bjohan/yig_filter_bank_controller/pcb/yigController.pdf

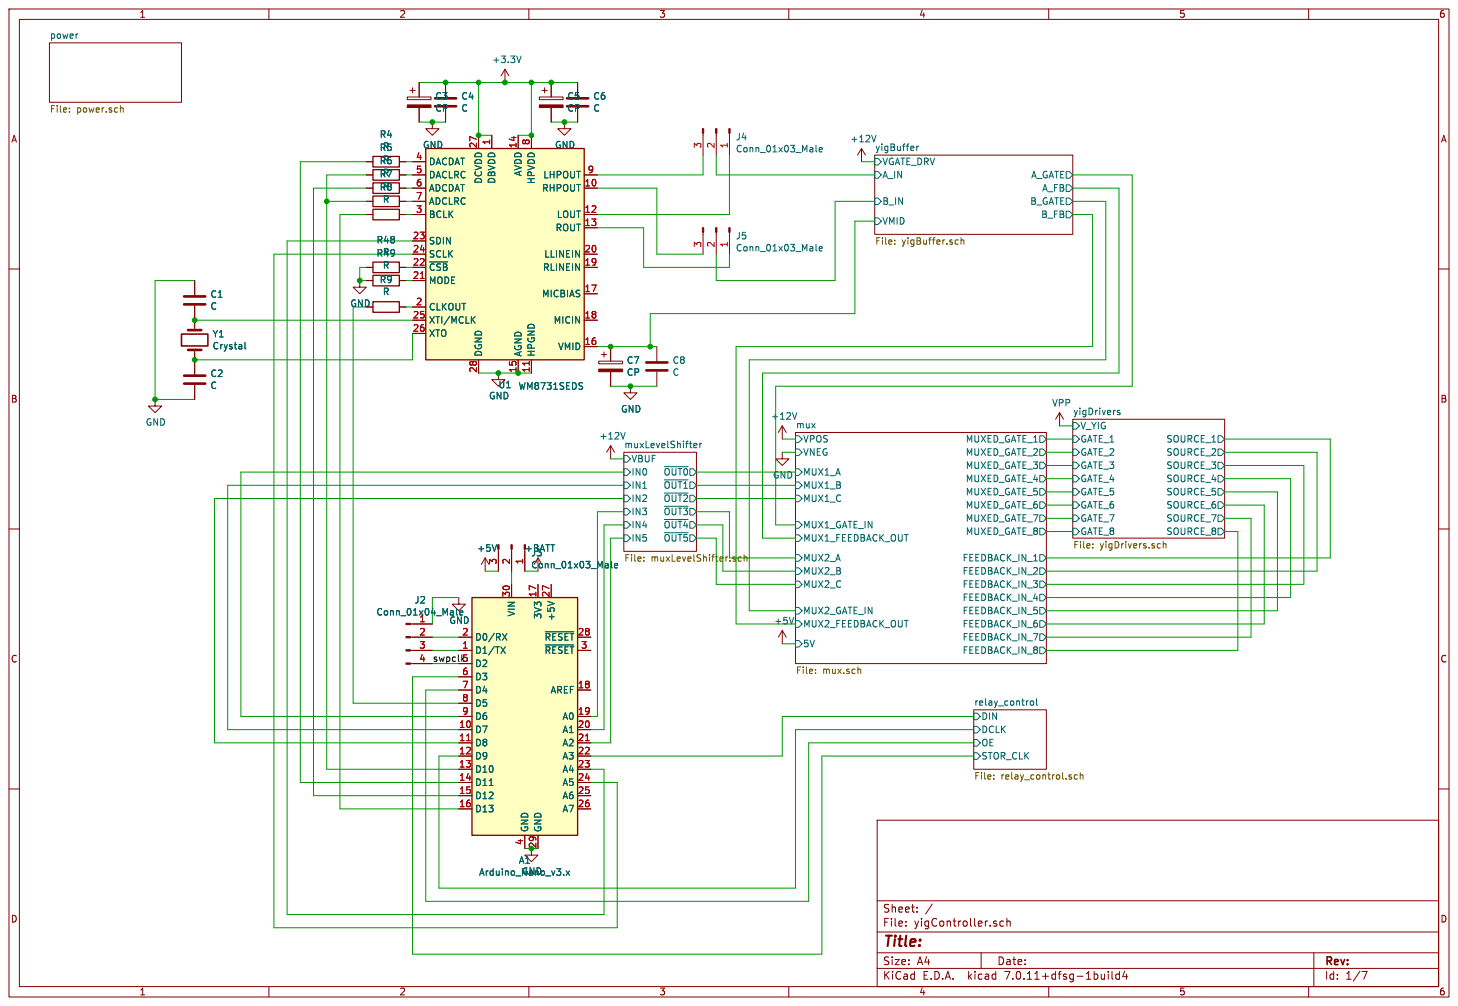
[picture p40: page 1]

power File: power.sch

yigDrivers File: yigDrivers.sch VPOS

Id: 1/7 Title: File: yigController.sch Sheet: /

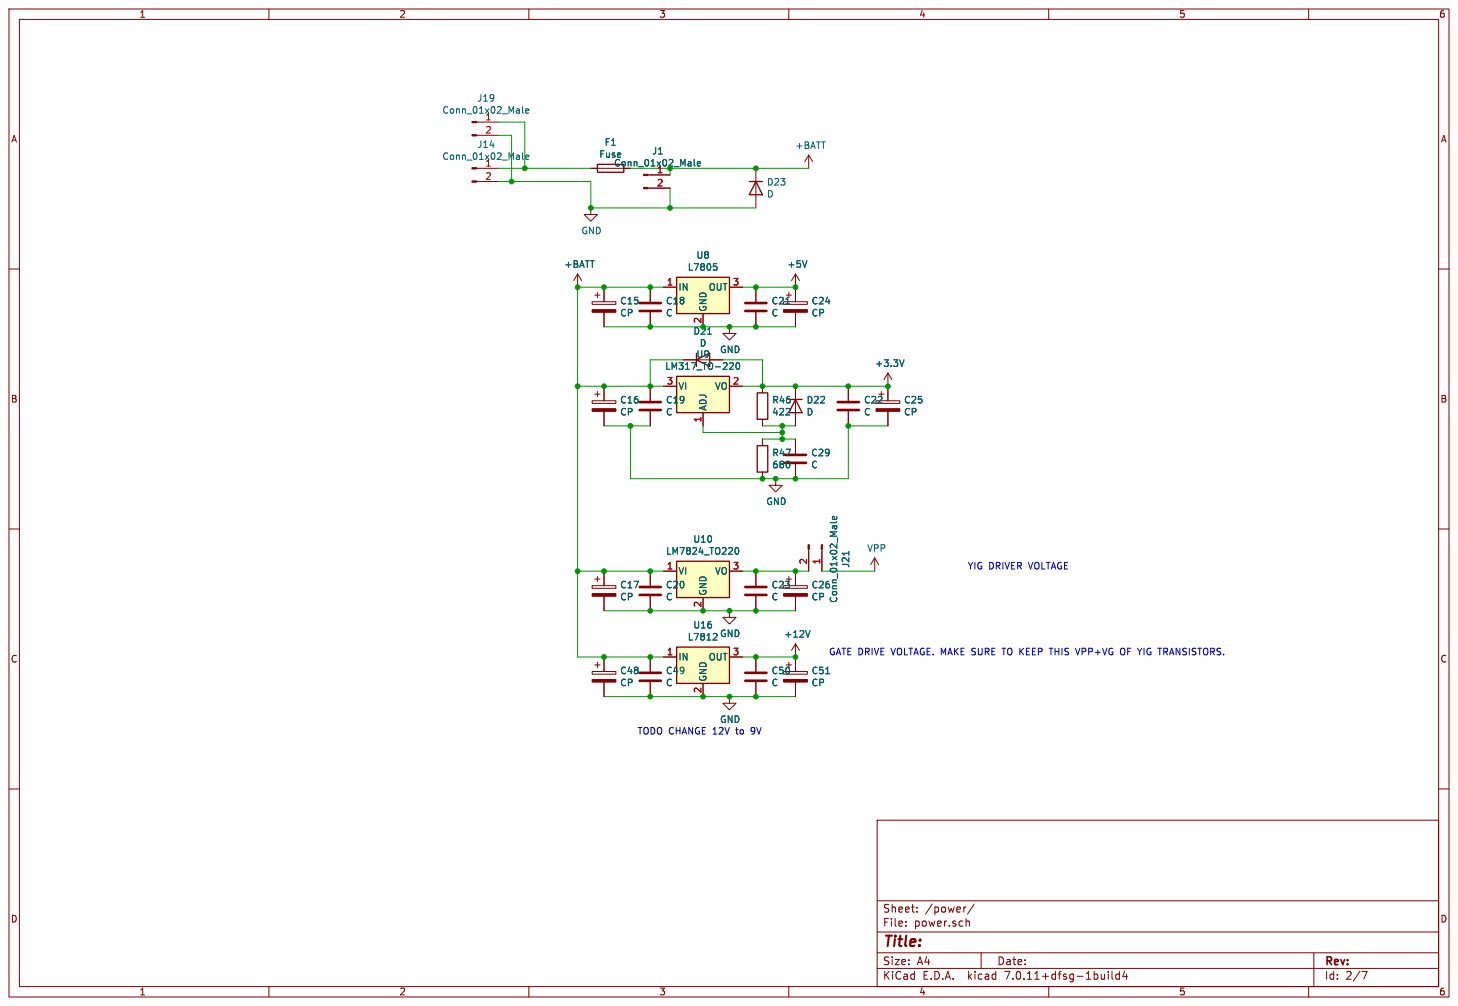
[picture p41: page 2]

Id: 2/7 Title: File: power.sch Sheet: /power/

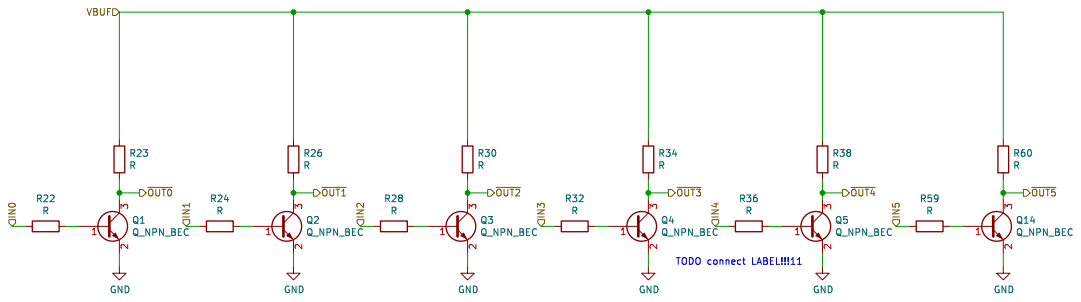
[picture p42: page 3]

Id: 3/7 Title: File: muxLevelShifter.sch Sheet: /muxLevelShifter/ GND

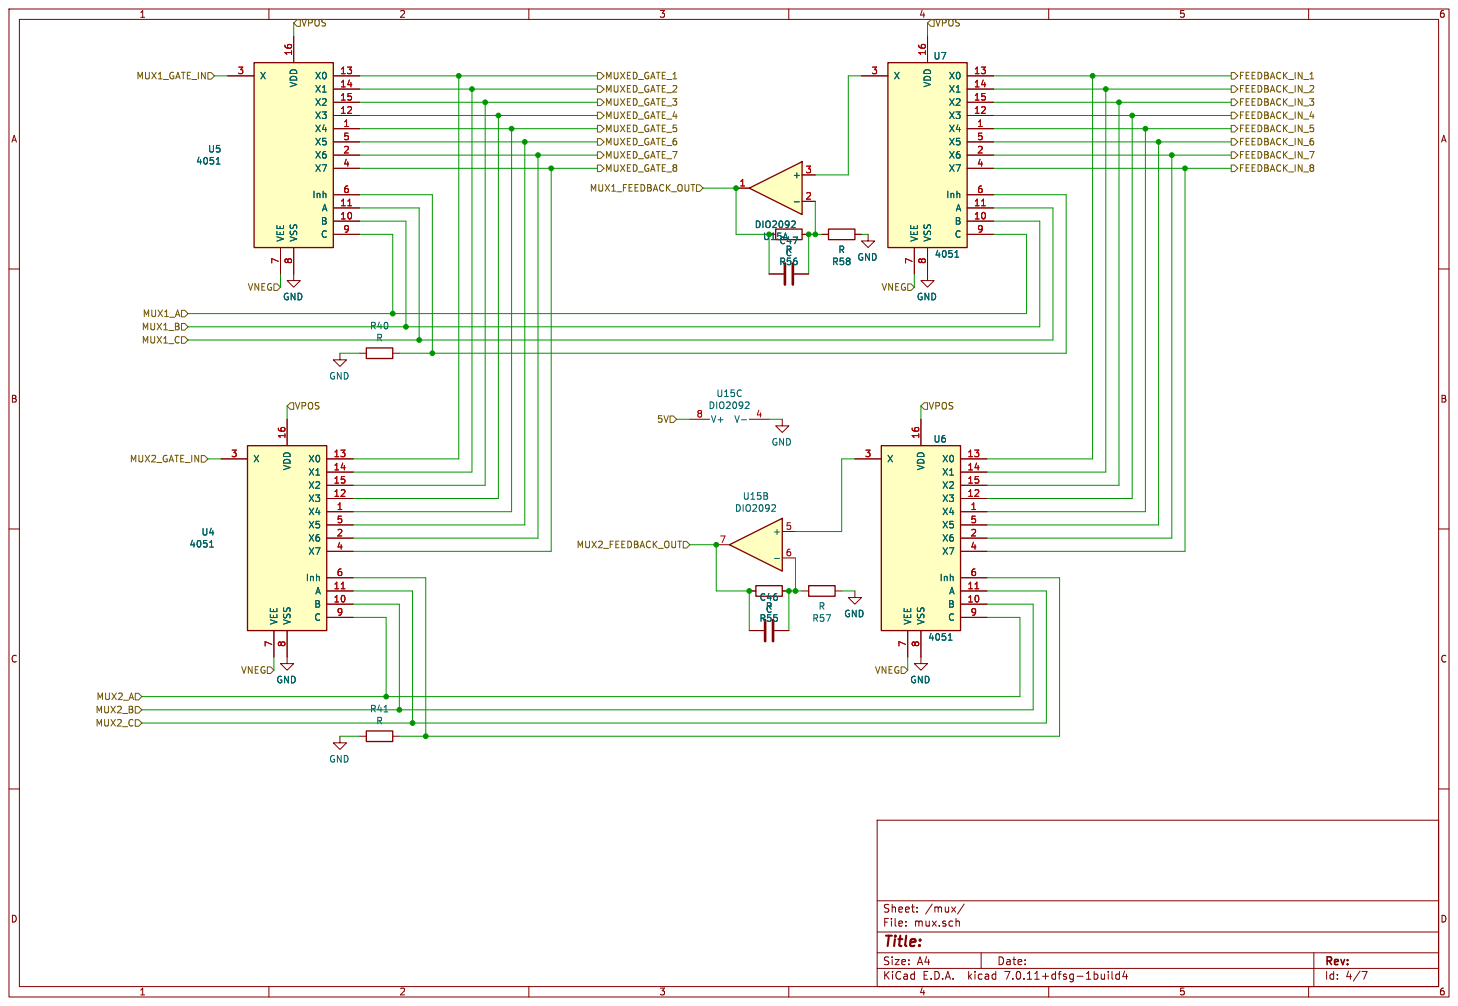
[picture p43: page 4]

Id: 4/7 Title: File: mux.sch Sheet: /mux/ GND GND

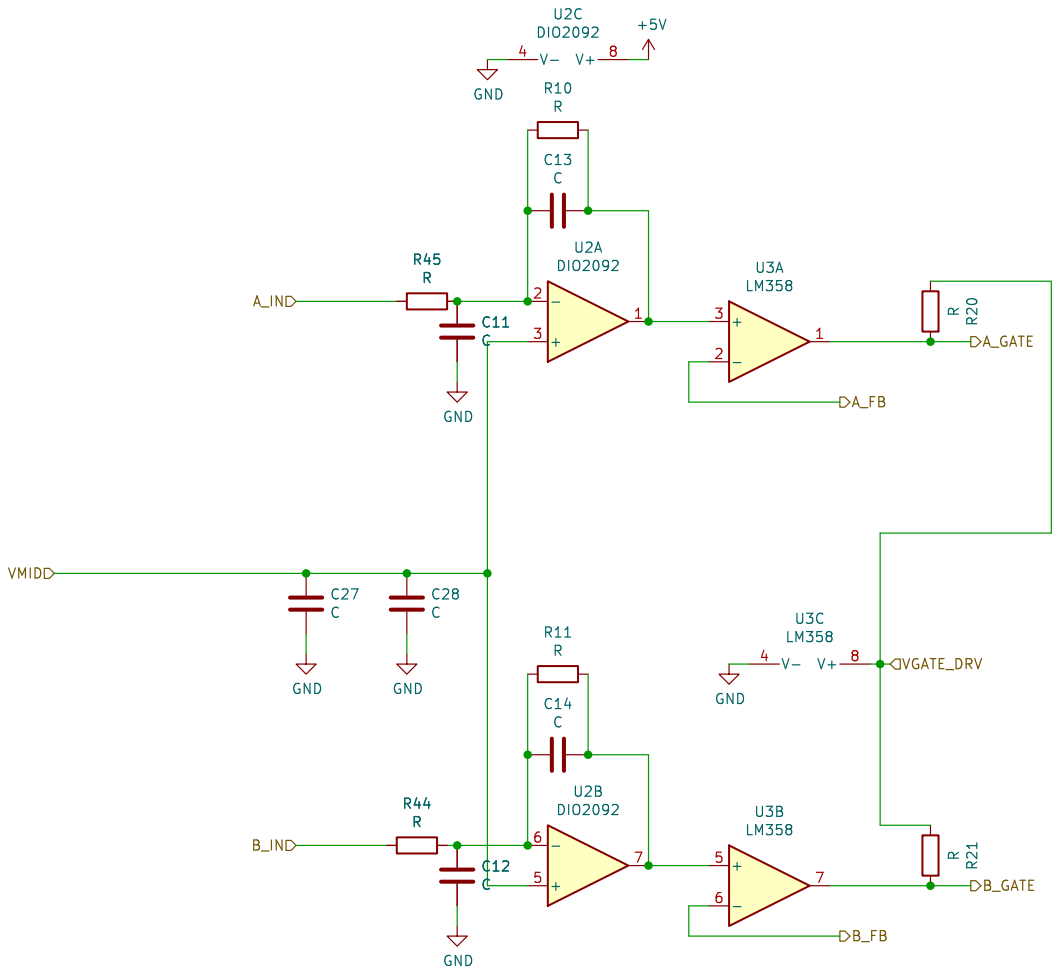
[picture p44: page 5]

Id: 5/7 Title: File: yigBuffer.sch Sheet: /yigBuffer/

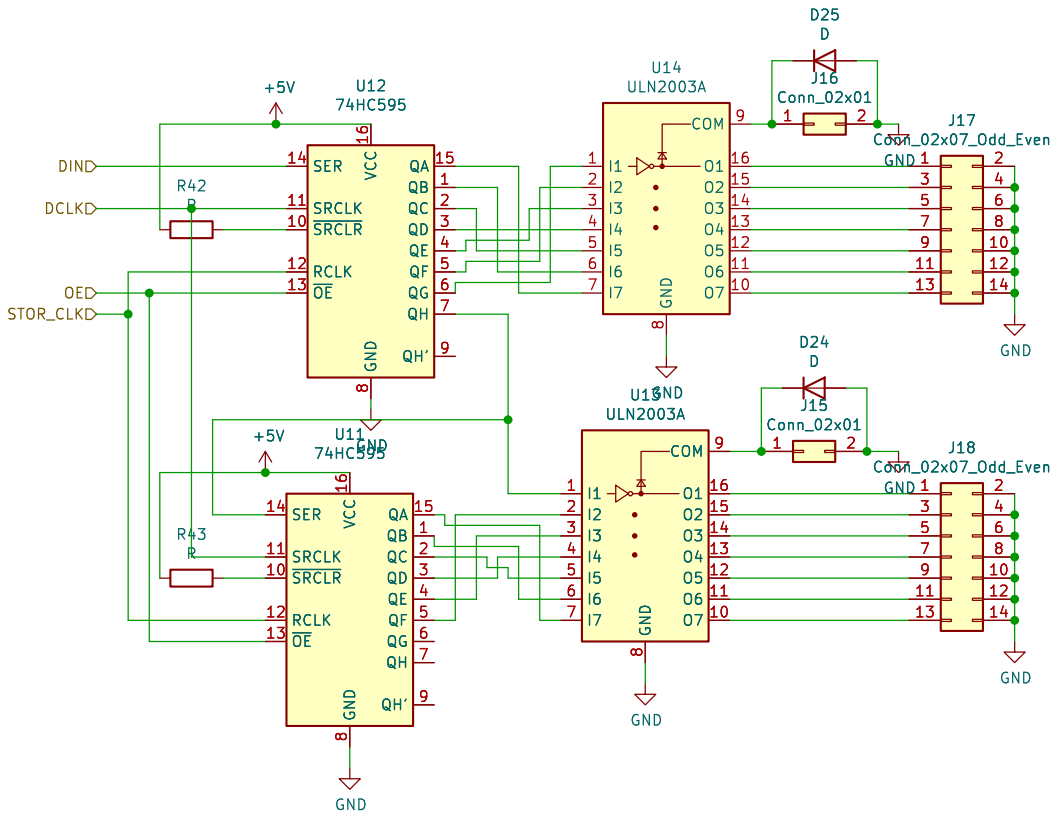
[picture p45: page 6]

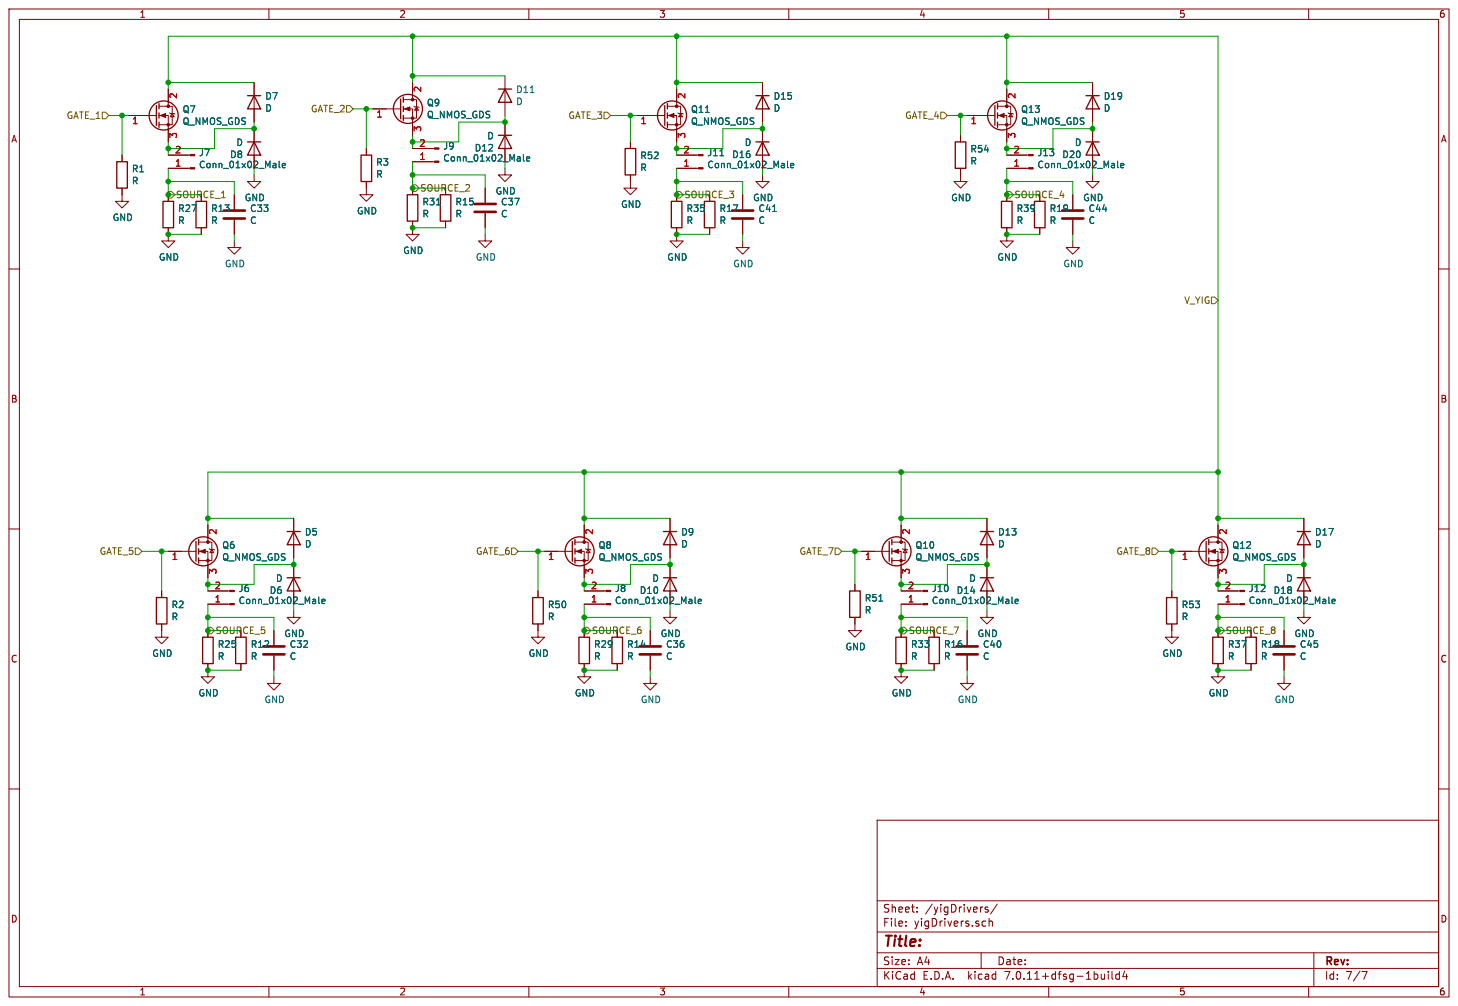
[picture p46: page 7]

Id: 7/7 Title: File: yigDrivers.sch Sheet: /yigDrivers/
