bjohan/yig_filter_bank_controller/pcb/yigController.kicad_pcb

## KiCad design pcb/yigController.kicad_pcb (2024-11-19)

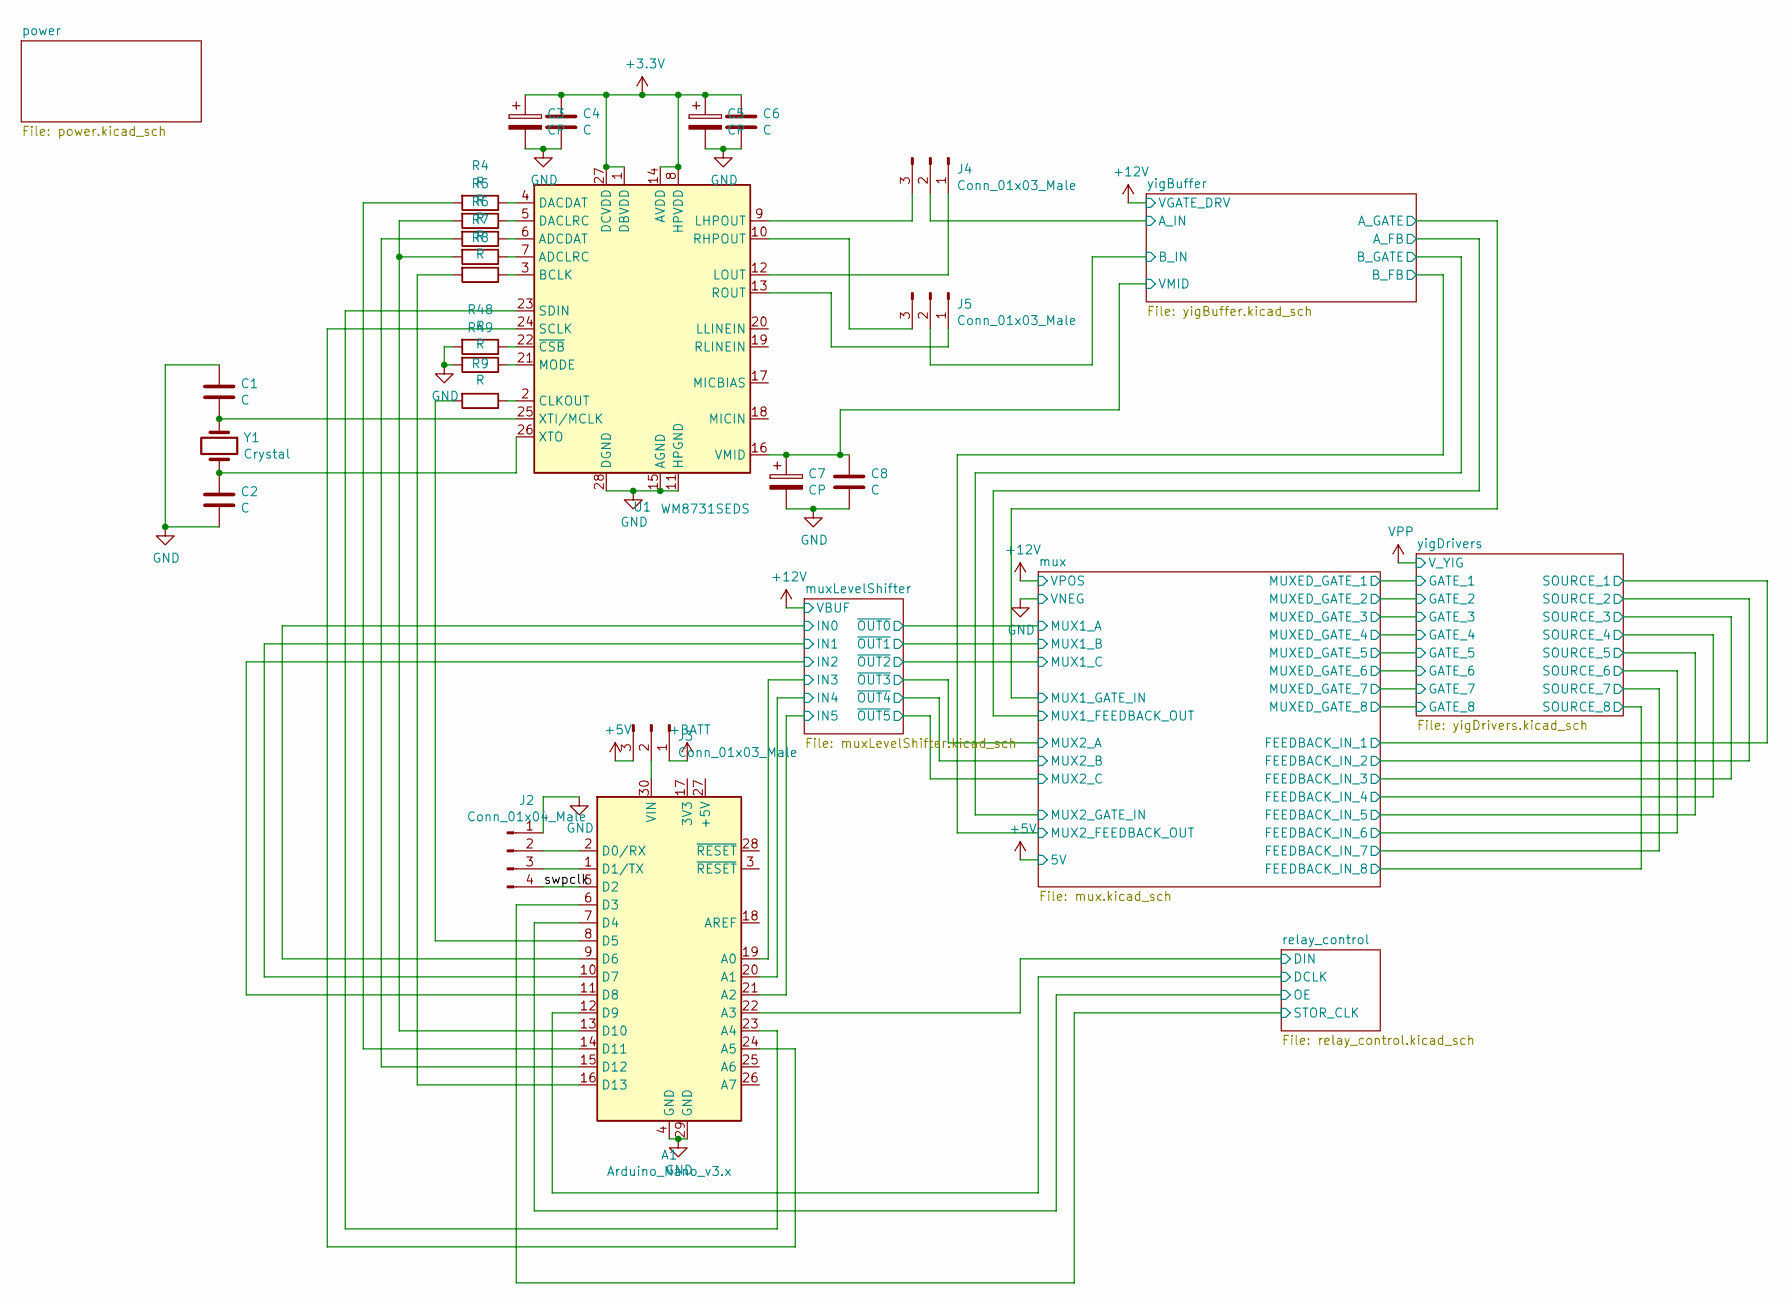
[picture p47: schematic yigController.kicad_sch]

Parts:
A1: Arduino_Nano_v3.x; Arduino_Nano
C1, C2, C4, C6, C8: C; C_1206_3216Metric
C3, C5, C7: CP; C_1206_3216Metric
J2: Conn_01x04_Male; PinHeader_1x04_P2.54mm_Vertical
J3, J4, J5: Conn_01x03_Male; PinHeader_1x03_P2.54mm_Vertical
R4, R5, R6, R7, R8, R9, R48, R49: R; R_1206_3216Metric
U1: WM8731SEDS; SSOP-28_5.3x10.2mm_P0.65mm
Y1: Crystal; Crystal_HC49-4H_Vertical

Connections:
+3V3: C3.1, C4.1, C5.1, C6.1, U1.1 (DBVDD), U1.8 (HPVDD), U1.14 (AVDD), U1.27 (DCVDD); also elsewhere on the board
+5V: J3.3; also elsewhere on the board
+BATT: J3.1; also elsewhere on the board
/muxLevelShifter/IN0: A1.9 (D6); also elsewhere on the board
/muxLevelShifter/IN1: A1.10 (D7); also elsewhere on the board
/muxLevelShifter/IN2: A1.11 (D8); also elsewhere on the board
/muxLevelShifter/IN3: A1.19 (A0); also elsewhere on the board
/muxLevelShifter/IN4: A1.20 (A1); also elsewhere on the board
/muxLevelShifter/IN5: A1.21 (A2); also elsewhere on the board
/relay_control/DCLK: A1.12 (D9); also elsewhere on the board
/relay_control/DIN: A1.22 (A3); also elsewhere on the board
/relay_control/OE: A1.7 (D4); also elsewhere on the board
/relay_control/STOR_CLK: A1.6 (D3); also elsewhere on the board
/swpclk: A1.5 (D2), J2.4
/yigBuffer/A_IN: J4.2; also elsewhere on the board
/yigBuffer/B_IN: J5.2; also elsewhere on the board
/yigBuffer/VMID: C7.1, C8.1, U1.16 (VMID); also elsewhere on the board
GND: A1.4 (GND), A1.29 (GND), C1.1, C2.2, C3.2, C4.2, C5.2, C6.2, C7.2, C8.2, J2.1, R48.2, R49.2, U1.11 (HPGND), U1.15 (AGND), U1.28 (DGND); also elsewhere on the board
unnamed: A1.1 (D1/TX), J2.3
unnamed: A1.2 (D0/RX), J2.2
unnamed: A1.8 (D5), R9.2
unnamed: A1.13 (D10), R5.2, R7.2
unnamed: A1.14 (D11), R4.2
unnamed: A1.15 (D12), R6.2
unnamed: A1.16 (D13), R8.2
unnamed: A1.23 (A4), U1.23 (SDIN)
unnamed: A1.24 (A5), U1.24 (SCLK)
unnamed: A1.30 (VIN), J3.2
unnamed: C1.2, U1.25 (XTI/MCLK), Y1.1
unnamed: C2.1, U1.26 (XTO), Y1.2
unnamed: J4.1, U1.12 (LOUT)
unnamed: J4.3, U1.9 (LHPOUT)
unnamed: J5.1, U1.13 (ROUT)
unnamed: J5.3, U1.10 (RHPOUT)
unnamed: R4.1, U1.4 (DACDAT)
unnamed: R5.1, U1.5 (DACLRC)
unnamed: R6.1, U1.6 (ADCDAT)
unnamed: R7.1, U1.7 (ADCLRC)
unnamed: R8.1, U1.3 (BCLK)
unnamed: R9.1, U1.2 (CLKOUT)
unnamed: R48.1, U1.22 (~CSB)
unnamed: R49.1, U1.21 (MODE)

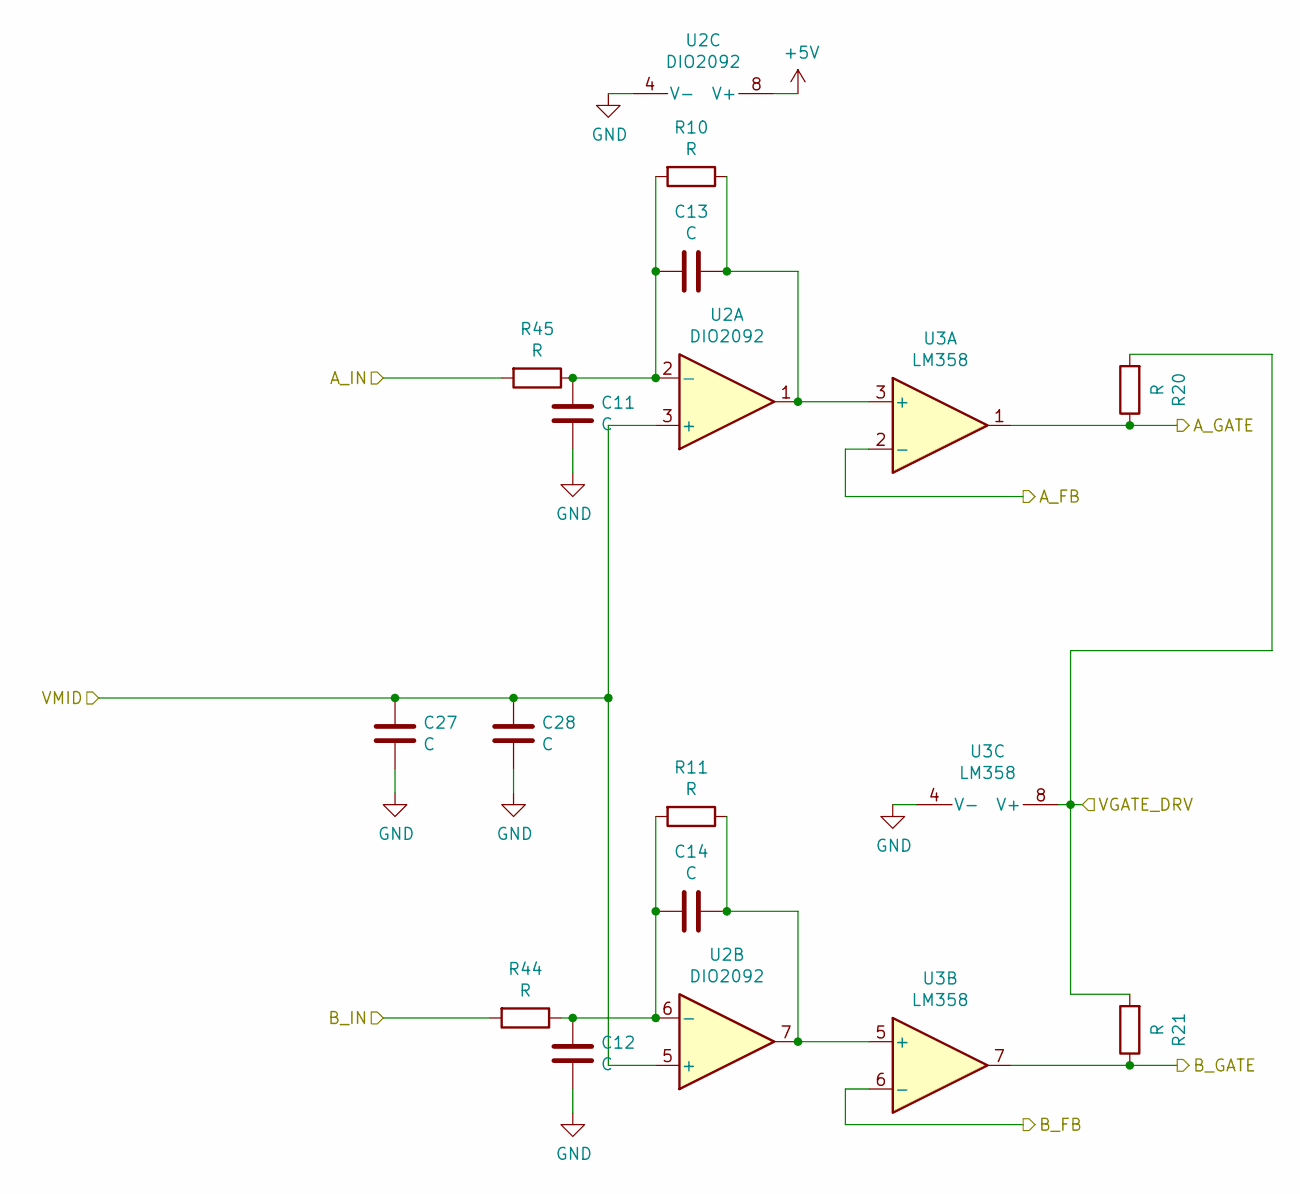
[picture p48: schematic yigBuffer.kicad_sch]

Parts:
C11, C12, C13, C14, C27, C28: C; C_1206_3216Metric
R10, R11, R20, R21, R44, R45: R; R_1206_3216Metric
U2: DIO2092; SOIC-8_3.9x4.9mm_P1.27mm
U3: LM358; SOIC-8_3.9x4.9mm_P1.27mm

Connections:
+5V: U2.8 (V+); also elsewhere on the board
+12V: R20.2, R21.2, U3.8 (V+); also elsewhere on the board
/yigBuffer/A_FB: U3.2 (-); also elsewhere on the board
/yigBuffer/A_GATE: R20.1, U3.1; also elsewhere on the board
/yigBuffer/A_IN: R45.2; also elsewhere on the board
/yigBuffer/B_FB: U3.6 (-); also elsewhere on the board
/yigBuffer/B_GATE: R21.1, U3.7; also elsewhere on the board
/yigBuffer/B_IN: R44.2; also elsewhere on the board
/yigBuffer/VMID: C27.1, C28.1, U2.3 (+), U2.5 (+); also elsewhere on the board
GND: C11.2, C12.2, C27.2, C28.2, U2.4 (V-), U3.4 (V-); also elsewhere on the board
unnamed: C11.1, C13.2, R10.2, R45.1, U2.2 (-)
unnamed: C12.1, C14.2, R11.2, R44.1, U2.6 (-)
unnamed: C13.1, R10.1, U2.1, U3.3 (+)
unnamed: C14.1, R11.1, U2.7, U3.5 (+)

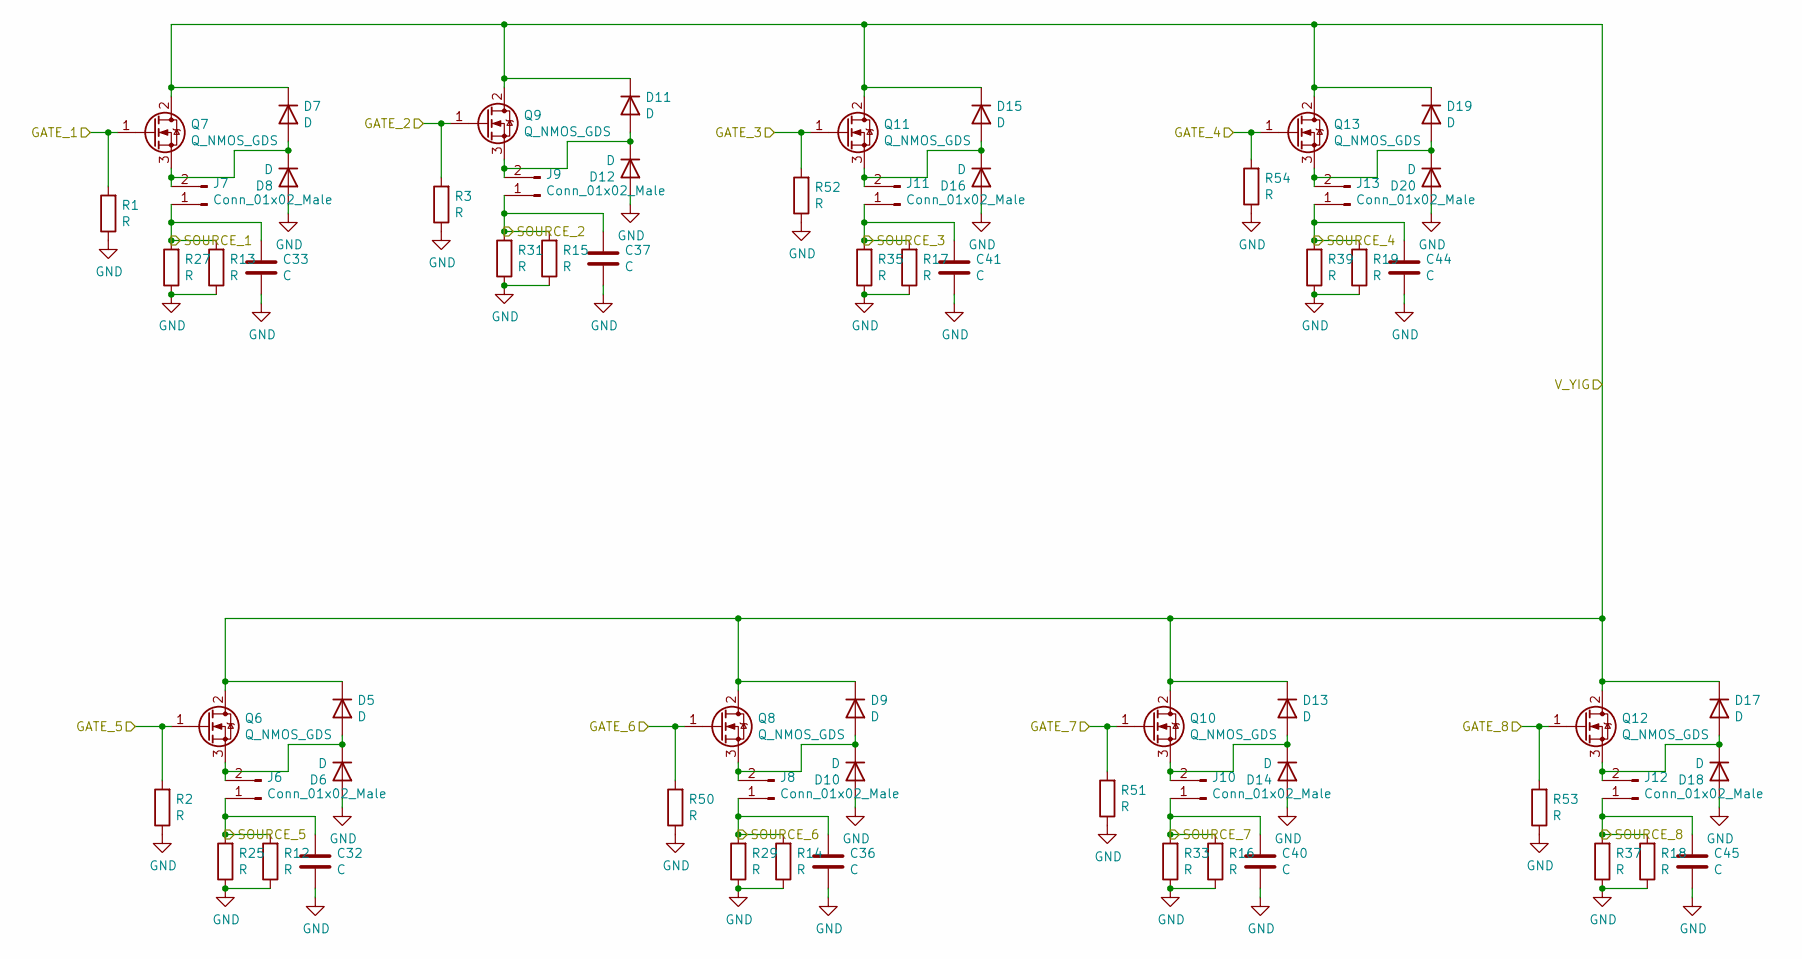
[picture p49: schematic yigDrivers.kicad_sch]

Parts:
C32, C33, C36, C37, C40, C41, C44, C45: C; C_1206_3216Metric
D5, D6, D7, D8, D9, D10, D11, D12, D13, D14, D15, D16, D17, D18, D19, D20: D; D_2010_5025Metric
J6, J7, J8, J9, J10, J11, J12, J13: Conn_01x02_Male; PinHeader_1x02_P2.54mm_Vertical
Q6, Q7, Q8, Q9, Q10, Q11, Q12, Q13: Q_NMOS_GDS; TO-220-3_Vertical
R1, R2, R3, R50, R51, R52, R53, R54: R; R_1206_3216Metric
R12, R13, R14, R15, R16, R17, R18, R19: R; R_2512_6332Metric
R25, R27, R29, R31, R33, R35, R37, R39: R; R_4020_10251Metric

Connections:
/mux/FEEDBACK_IN_1: C33.1, J7.1, R13.2, R27.2; also elsewhere on the board
/mux/FEEDBACK_IN_2: C37.1, J9.1, R15.2, R31.2; also elsewhere on the board
/mux/FEEDBACK_IN_3: C41.1, J11.1, R17.2, R35.2; also elsewhere on the board
/mux/FEEDBACK_IN_4: C44.1, J13.1, R19.2, R39.2; also elsewhere on the board
/mux/FEEDBACK_IN_5: C32.1, J6.1, R12.2, R25.2; also elsewhere on the board
/mux/FEEDBACK_IN_6: C36.1, J8.1, R14.2, R29.2; also elsewhere on the board
/mux/FEEDBACK_IN_7: C40.1, J10.1, R16.2, R33.2; also elsewhere on the board
/mux/FEEDBACK_IN_8: C45.1, J12.1, R18.2, R37.2; also elsewhere on the board
/yigDrivers/GATE_1: Q7.1 (G), R1.2; also elsewhere on the board
/yigDrivers/GATE_2: Q9.1 (G), R3.2; also elsewhere on the board
/yigDrivers/GATE_3: Q11.1 (G), R52.2; also elsewhere on the board
/yigDrivers/GATE_4: Q13.1 (G), R54.2; also elsewhere on the board
/yigDrivers/GATE_5: Q6.1 (G), R2.2; also elsewhere on the board
/yigDrivers/GATE_6: Q8.1 (G), R50.2; also elsewhere on the board
/yigDrivers/GATE_7: Q10.1 (G), R51.2; also elsewhere on the board
/yigDrivers/GATE_8: Q12.1 (G), R53.2; also elsewhere on the board
GND: C32.2, C33.2, C36.2, C37.2, C40.2, C41.2, C44.2, C45.2, D6.2 (A), D8.2 (A), D10.2 (A), D12.2 (A), D14.2 (A), D16.2 (A), D18.2 (A), D20.2 (A), R1.1, R2.1, R3.1, R12.1, R13.1, R14.1, R15.1, R16.1, R17.1, R18.1, R19.1, R25.1, R27.1, R29.1, R31.1, R33.1, R35.1, R37.1, R39.1, R50.1, R51.1, R52.1, R53.1, R54.1; also elsewhere on the board
unnamed: D5.2 (A), D6.1 (K), J6.2, Q6.3 (S)
unnamed: D7.2 (A), D8.1 (K), J7.2, Q7.3 (S)
unnamed: D9.2 (A), D10.1 (K), J8.2, Q8.3 (S)
unnamed: D11.2 (A), D12.1 (K), J9.2, Q9.3 (S)
unnamed: D13.2 (A), D14.1 (K), J10.2, Q10.3 (S)
unnamed: D15.2 (A), D16.1 (K), J11.2, Q11.3 (S)
unnamed: D17.2 (A), D18.1 (K), J12.2, Q12.3 (S)
unnamed: D19.2 (A), D20.1 (K), J13.2, Q13.3 (S)
VPP: D5.1 (K), D7.1 (K), D9.1 (K), D11.1 (K), D13.1 (K), D15.1 (K), D17.1 (K), D19.1 (K), Q6.2 (D), Q7.2 (D), Q8.2 (D), Q9.2 (D), Q10.2 (D), Q11.2 (D), Q12.2 (D), Q13.2 (D); also elsewhere on the board

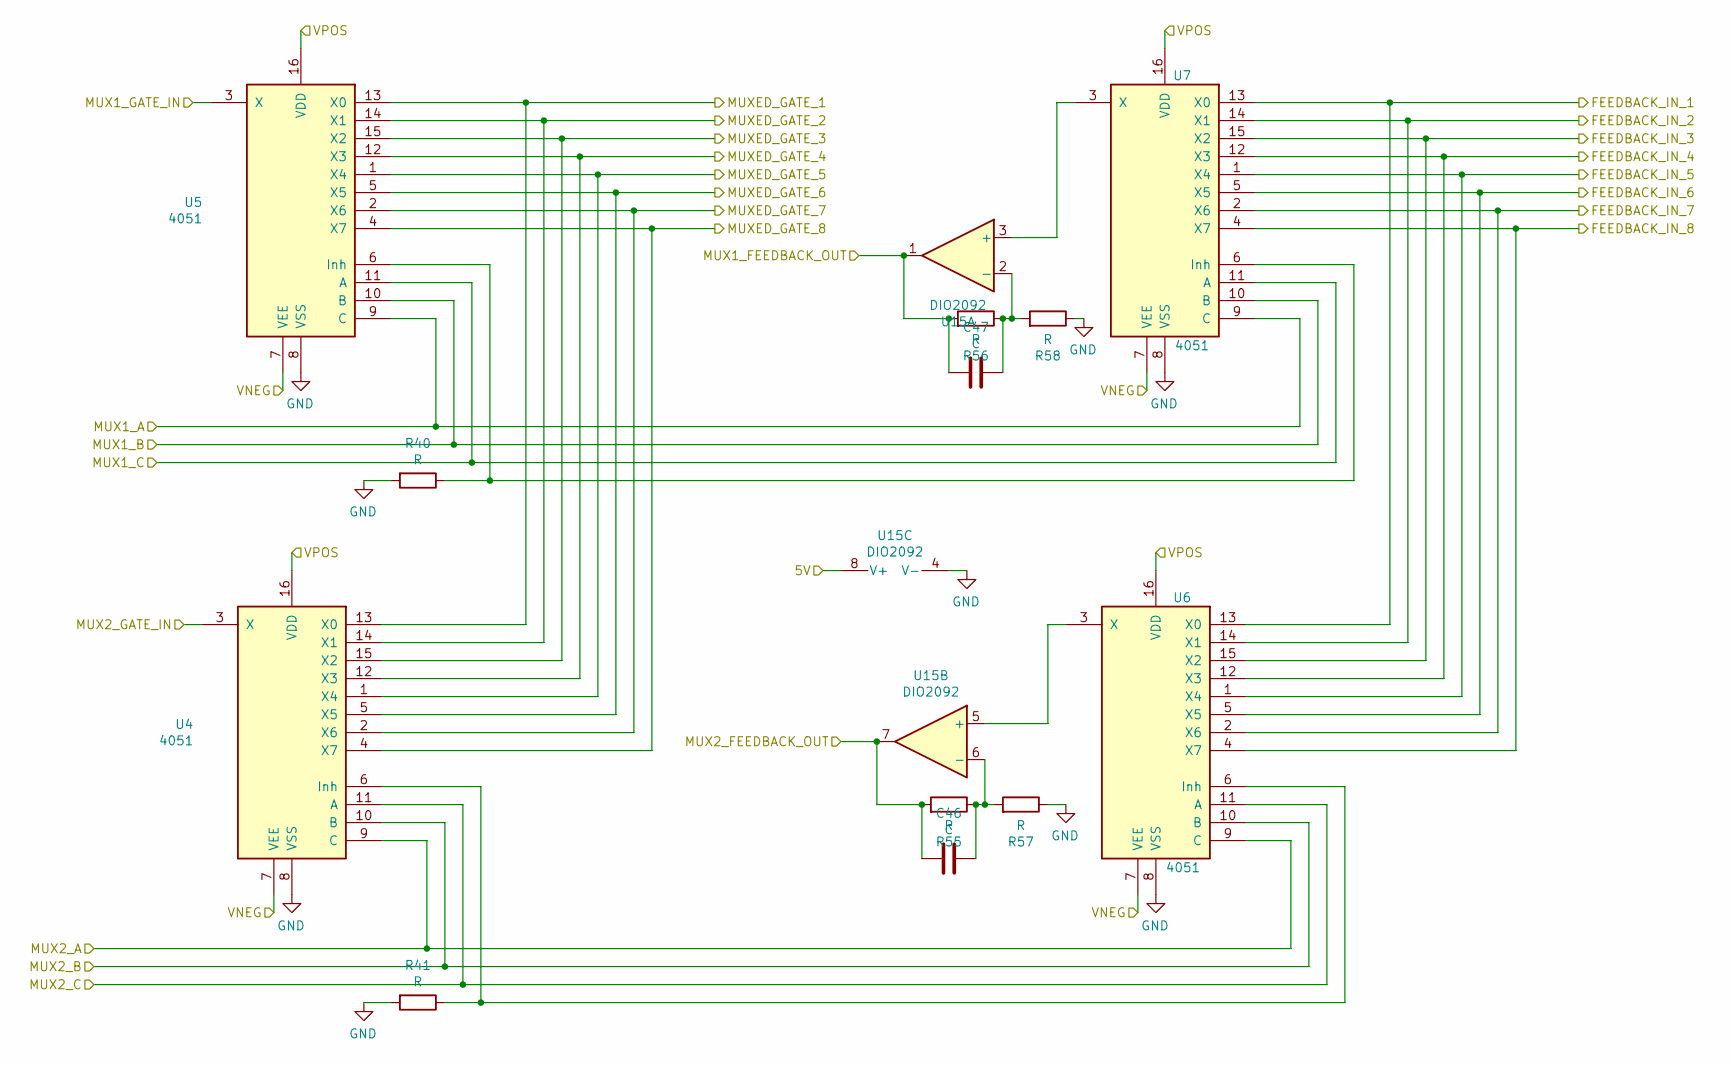
[picture p50: schematic mux.kicad_sch]

Parts:
C46, C47: C; C_1206_3216Metric
R40, R41, R55, R56, R57, R58: R; R_1206_3216Metric
U4, U5, U6, U7: 4051; SOIC-16_3.9x9.9mm_P1.27mm
U15: DIO2092; SOIC-8_3.9x4.9mm_P1.27mm

Connections:
+5V: U15.8 (V+); also elsewhere on the board
+12V: U4.16 (VDD), U5.16 (VDD), U6.16 (VDD), U7.16 (VDD); also elsewhere on the board
/mux/FEEDBACK_IN_1: U6.13 (X0), U7.13 (X0); also elsewhere on the board
/mux/FEEDBACK_IN_2: U6.14 (X1), U7.14 (X1); also elsewhere on the board
/mux/FEEDBACK_IN_3: U6.15 (X2), U7.15 (X2); also elsewhere on the board
/mux/FEEDBACK_IN_4: U6.12 (X3), U7.12 (X3); also elsewhere on the board
/mux/FEEDBACK_IN_5: U6.1 (X4), U7.1 (X4); also elsewhere on the board
/mux/FEEDBACK_IN_6: U6.5 (X5), U7.5 (X5); also elsewhere on the board
/mux/FEEDBACK_IN_7: U6.2 (X6), U7.2 (X6); also elsewhere on the board
/mux/FEEDBACK_IN_8: U6.4 (X7), U7.4 (X7); also elsewhere on the board
/mux/MUX1_A: U5.9 (C), U7.9 (C); also elsewhere on the board
/mux/MUX1_B: U5.10 (B), U7.10 (B); also elsewhere on the board
/mux/MUX1_C: U5.11 (A), U7.11 (A); also elsewhere on the board
/mux/MUX2_A: U4.9 (C), U6.9 (C); also elsewhere on the board
/mux/MUX2_B: U4.10 (B), U6.10 (B); also elsewhere on the board
/mux/MUX2_C: U4.11 (A), U6.11 (A); also elsewhere on the board
/yigBuffer/A_FB: C47.2, R56.2, U15.1; also elsewhere on the board
/yigBuffer/A_GATE: U5.3 (X); also elsewhere on the board
/yigBuffer/B_FB: C46.2, R55.2, U15.7; also elsewhere on the board
/yigBuffer/B_GATE: U4.3 (X); also elsewhere on the board
/yigDrivers/GATE_1: U4.13 (X0), U5.13 (X0); also elsewhere on the board
/yigDrivers/GATE_2: U4.14 (X1), U5.14 (X1); also elsewhere on the board
/yigDrivers/GATE_3: U4.15 (X2), U5.15 (X2); also elsewhere on the board
/yigDrivers/GATE_4: U4.12 (X3), U5.12 (X3); also elsewhere on the board
/yigDrivers/GATE_5: U4.1 (X4), U5.1 (X4); also elsewhere on the board
/yigDrivers/GATE_6: U4.5 (X5), U5.5 (X5); also elsewhere on the board
/yigDrivers/GATE_7: U4.2 (X6), U5.2 (X6); also elsewhere on the board
/yigDrivers/GATE_8: U4.4 (X7), U5.4 (X7); also elsewhere on the board
GND: R40.2, R41.2, R57.1, R58.1, U4.7 (VEE), U4.8 (VSS), U5.7 (VEE), U5.8 (VSS), U6.7 (VEE), U6.8 (VSS), U7.7 (VEE), U7.8 (VSS), U15.4 (V-); also elsewhere on the board
unnamed: C46.1, R55.1, R57.2, U15.6 (-)
unnamed: C47.1, R56.1, R58.2, U15.2 (-)
unnamed: R40.1, U5.6 (Inh), U7.6 (Inh)
unnamed: R41.1, U4.6 (Inh), U6.6 (Inh)
unnamed: U7.3 (X), U15.3 (+)
unnamed: U6.3 (X), U15.5 (+)

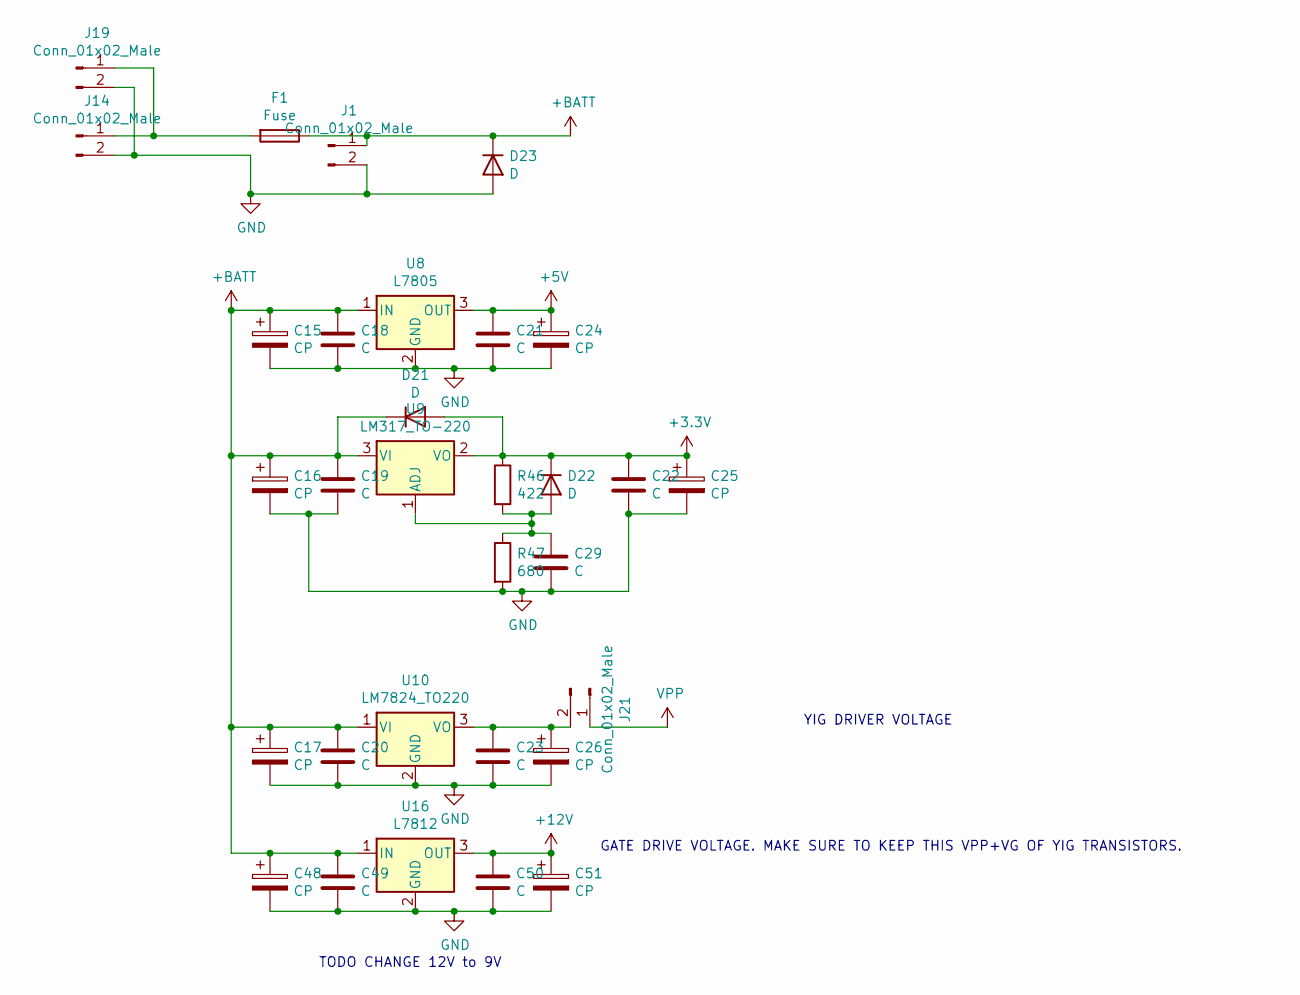
[picture p51: schematic power.kicad_sch]

Parts:
C15, C16, C17, C24, C25, C26, C48, C51: CP; CP_Elec_10x12.5
C18, C19, C20, C21, C22, C23, C29, C49, C50: C; C_1206_3216Metric
D21, D22, D23: D; D_2010_5025Metric
F1: Fuse; Fuse_1206_3216Metric
J1, J14, J19, J21: Conn_01x02_Male; PinHeader_1x02_P2.54mm_Vertical
R46: 422; R_1206_3216Metric
R47: 680; R_1206_3216Metric
U8: L7805; TO-220-3_Vertical
U9: LM317_TO-220; TO-220-3_Vertical
U10: LM7824_TO220; TO-220-3_Vertical
U16: L7812; TO-220-3_Vertical

Connections:
+3V3: C22.1, C25.1, D21.2 (A), D22.1 (K), R46.1, U9.2 (VO); also elsewhere on the board
+5V: C21.1, C24.1, U8.3 (OUT); also elsewhere on the board
+12V: C50.1, C51.1, U16.3 (OUT); also elsewhere on the board
+BATT: C15.1, C16.1, C17.1, C18.1, C19.1, C20.1, C48.1, C49.1, D21.1 (K), D23.1 (K), F1.1, J1.1, U8.1 (IN), U9.3 (VI), U10.1 (VI), U16.1 (IN); also elsewhere on the board
GND: C15.2, C16.2, C17.2, C18.2, C19.2, C20.2, C21.2, C22.2, C23.2, C24.2, C25.2, C26.2, C29.2, C48.2, C49.2, C50.2, C51.2, D23.2 (A), J1.2, J14.2, J19.2, R47.2, U8.2 (GND), U10.2 (GND), U16.2 (GND); also elsewhere on the board
unnamed: C23.1, C26.1, J21.2, U10.3 (VO)
unnamed: C29.1, D22.2 (A), R46.2, R47.1, U9.1 (ADJ)
unnamed: F1.2, J14.1, J19.1
VPP: J21.1; also elsewhere on the board

Notes on the sheet:
YIG DRIVER VOLTAGE
TODO CHANGE 12V to 9V
GATE DRIVE VOLTAGE. MAKE SURE TO KEEP THIS VPP+VG OF YIG TRANSISTORS.

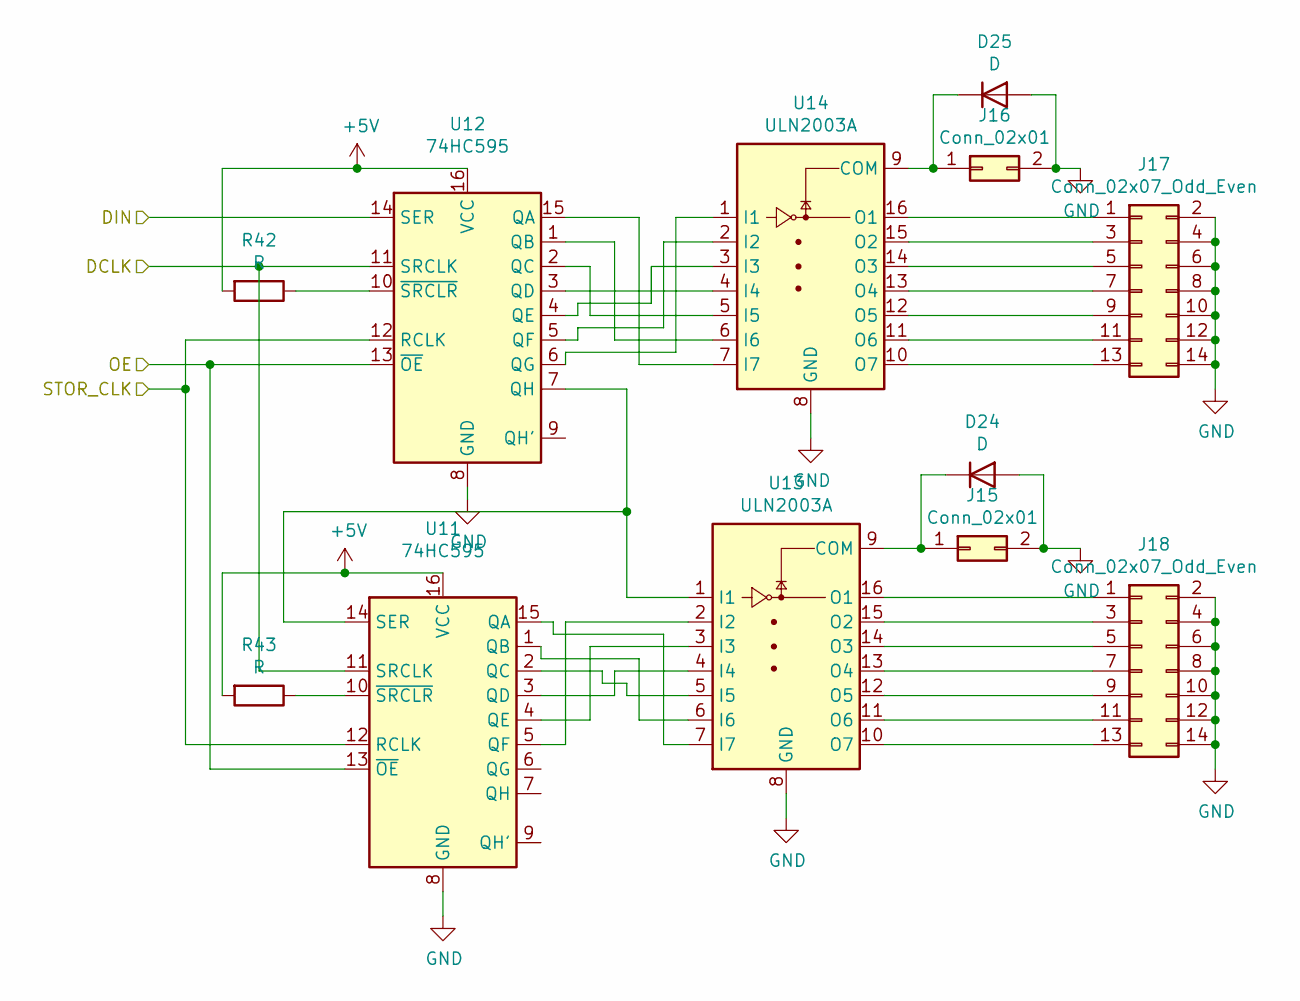
[picture p52: schematic relay_control.kicad_sch]

Parts:
D24, D25: D; D_2010_5025Metric
J15, J16: Conn_02x01; PinHeader_1x02_P2.54mm_Vertical
J17, J18: Conn_02x07_Odd_Even; PinHeader_2x07_P2.54mm_Vertical
R42, R43: R; R_1206_3216Metric
U11, U12: 74HC595; TSSOP-16_4.4x5mm_P0.65mm
U13, U14: ULN2003A; SOIC-16_3.9x9.9mm_P1.27mm

Connections:
+5V: R42.2, R43.2, U11.16 (VCC), U12.16 (VCC); also elsewhere on the board
/relay_control/DCLK: U11.11 (SRCLK), U12.11 (SRCLK); also elsewhere on the board
/relay_control/DIN: U12.14 (SER); also elsewhere on the board
/relay_control/OE: U11.13 (~OE), U12.13 (~OE); also elsewhere on the board
/relay_control/STOR_CLK: U11.12 (RCLK), U12.12 (RCLK); also elsewhere on the board
GND: D24.2 (A), D25.2 (A), J15.2, J16.2, J17.2, J17.4, J17.6, J17.8, J17.10, J17.12, J17.14, J18.2, J18.4, J18.6, J18.8, J18.10, J18.12, J18.14, U11.8 (GND), U12.8 (GND), U13.8 (GND), U14.8 (GND); also elsewhere on the board
unnamed: D24.1 (K), J15.1, U13.9 (COM)
unnamed: D25.1 (K), J16.1, U14.9 (COM)
unnamed: J17.1, U14.16 (O1)
unnamed: J17.3, U14.15 (O2)
unnamed: J17.5, U14.14 (O3)
unnamed: J17.7, U14.13 (O4)
unnamed: J17.9, U14.12 (O5)
unnamed: J17.11, U14.11 (O6)
unnamed: J17.13, U14.10 (O7)
unnamed: J18.1, U13.16 (O1)
unnamed: J18.3, U13.15 (O2)
unnamed: J18.5, U13.14 (O3)
unnamed: J18.7, U13.13 (O4)
unnamed: J18.9, U13.12 (O5)
unnamed: J18.11, U13.11 (O6)
unnamed: J18.13, U13.10 (O7)
unnamed: R42.1, U12.10 (~SRCLR)
unnamed: R43.1, U11.10 (~SRCLR)
unnamed: U11.1 (QB), U13.6 (I6)
unnamed: U11.2 (QC), U13.5 (I5)
unnamed: U11.3 (QD), U13.4 (I4)
unnamed: U11.4 (QE), U13.3 (I3)
unnamed: U11.5 (QF), U13.2 (I2)
unnamed: U11.14 (SER), U12.7 (QH), U13.1 (I1)
unnamed: U11.15 (QA), U13.7 (I7)
unnamed: U12.1 (QB), U14.6 (I6)
unnamed: U12.2 (QC), U14.5 (I5)
unnamed: U12.3 (QD), U14.4 (I4)
unnamed: U12.4 (QE), U14.3 (I3)
unnamed: U12.5 (QF), U14.2 (I2)
unnamed: U12.6 (QG), U14.1 (I1)
unnamed: U12.15 (QA), U14.7 (I7)

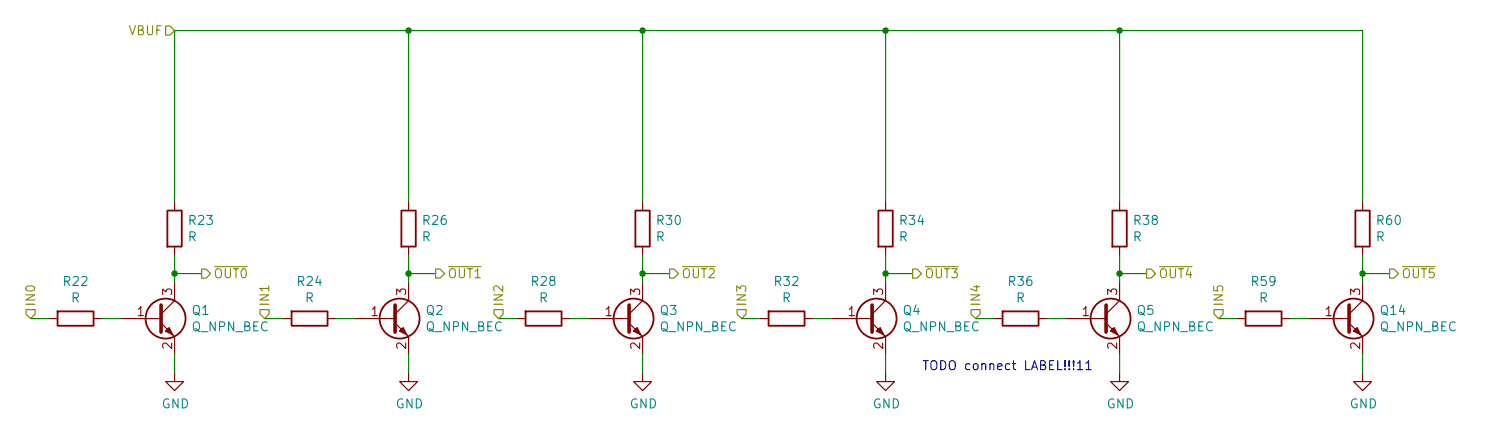
[picture p53: schematic muxLevelShifter.kicad_sch]

Parts:
Q1, Q2, Q3, Q4, Q5, Q14: Q_NPN_BEC; SOT-23
R22, R23, R24, R26, R28, R30, R32, R34, R36, R38, R59, R60: R; R_1206_3216Metric

Connections:
+12V: R23.1, R26.1, R30.1, R34.1, R38.1, R60.1; also elsewhere on the board
/mux/MUX1_A: Q1.3 (C), R23.2; also elsewhere on the board
/mux/MUX1_B: Q2.3 (C), R26.2; also elsewhere on the board
/mux/MUX1_C: Q3.3 (C), R30.2; also elsewhere on the board
/mux/MUX2_A: Q4.3 (C), R34.2; also elsewhere on the board
/mux/MUX2_B: Q5.3 (C), R38.2; also elsewhere on the board
/mux/MUX2_C: Q14.3 (C), R60.2; also elsewhere on the board
/muxLevelShifter/IN0: R22.2; also elsewhere on the board
/muxLevelShifter/IN1: R24.2; also elsewhere on the board
/muxLevelShifter/IN2: R28.2; also elsewhere on the board
/muxLevelShifter/IN3: R32.2; also elsewhere on the board
/muxLevelShifter/IN4: R36.2; also elsewhere on the board
/muxLevelShifter/IN5: R59.2; also elsewhere on the board
GND: Q1.2 (E), Q2.2 (E), Q3.2 (E), Q4.2 (E), Q5.2 (E), Q14.2 (E); also elsewhere on the board
unnamed: Q1.1 (B), R22.1
unnamed: Q2.1 (B), R24.1
unnamed: Q3.1 (B), R28.1
unnamed: Q4.1 (B), R32.1
unnamed: Q5.1 (B), R36.1
unnamed: Q14.1 (B), R59.1

Notes on the sheet:
TODO connect LABEL!!!11

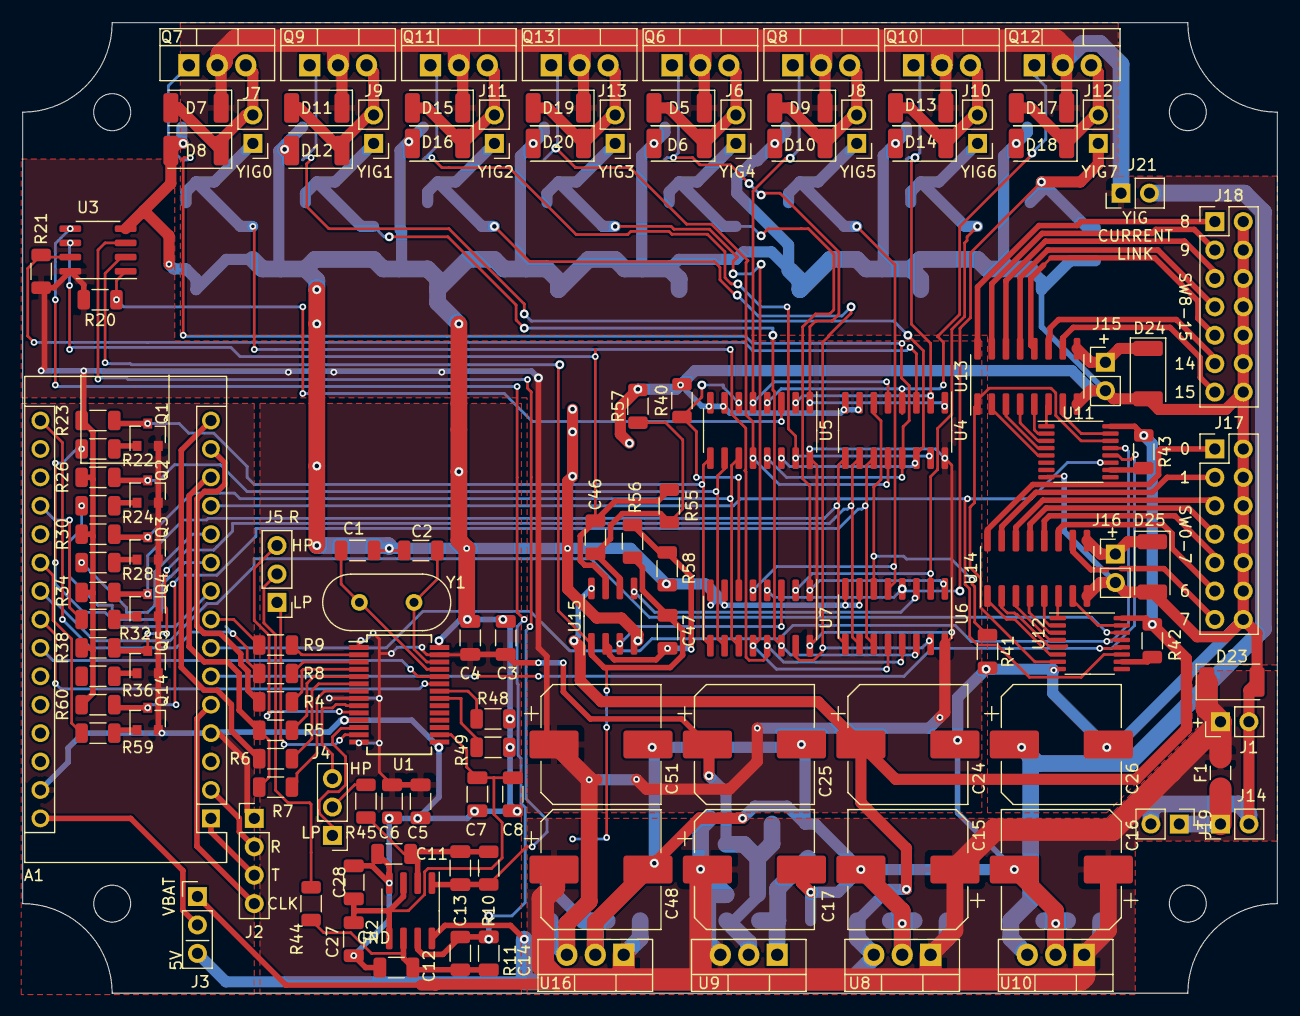
[picture p54: board yigController.kicad_pcb from above]

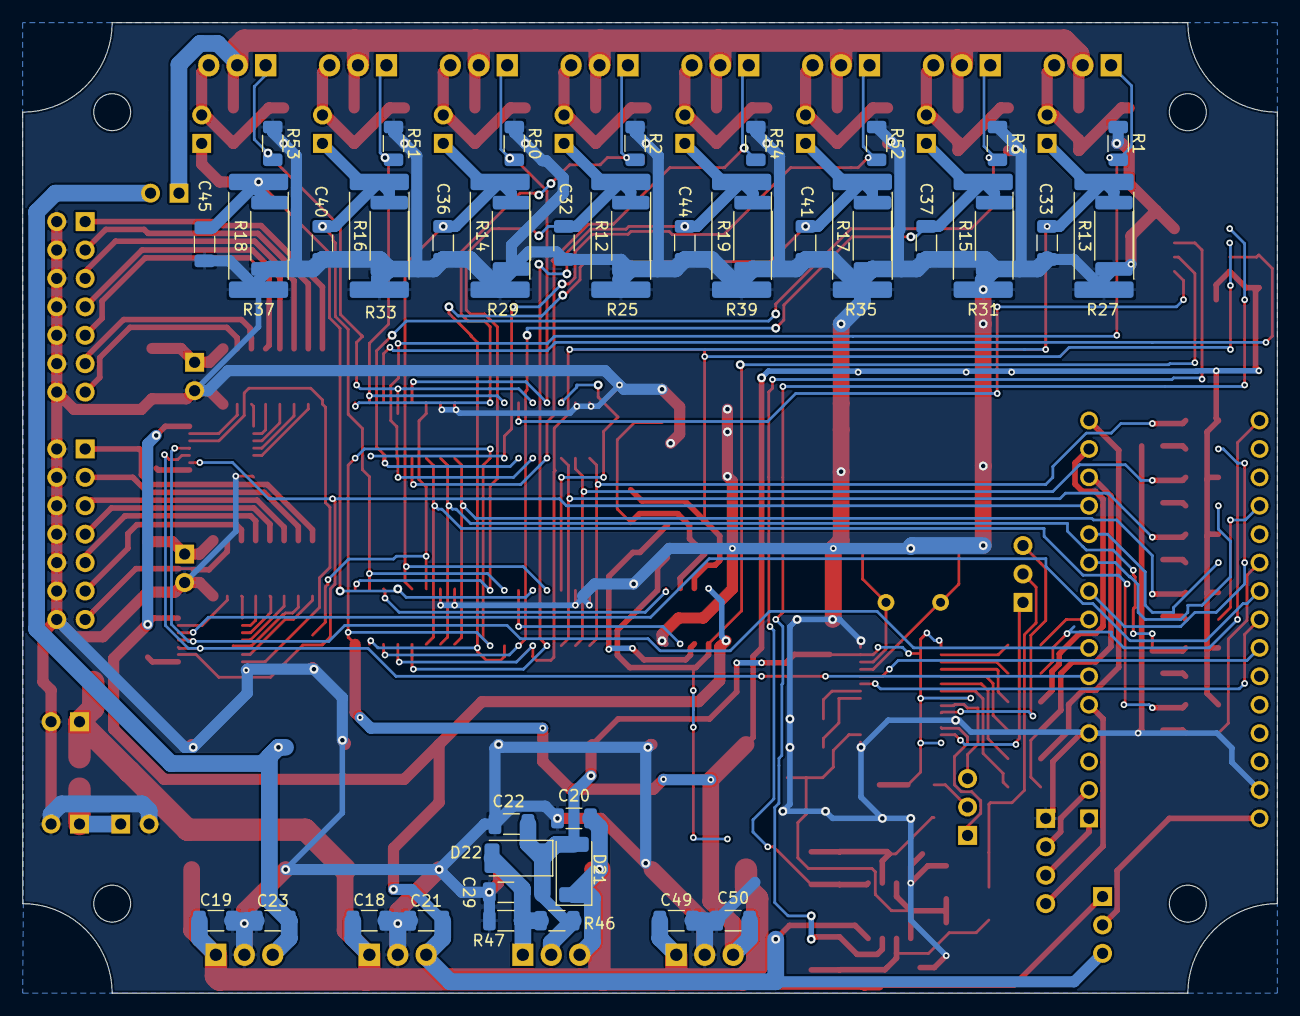
[picture p55: board yigController.kicad_pcb from below]

Board: 2 copper layers, 112.1 x 86.7 mm, 175 parts (45 on the bottom side), 129 nets.
