bjohan/yig_filter_bank_controller/(commit log)

2022-05-02 Added more measurements in notebook for automatic yig filter learning
2022-05-06 Added measurements to get data for filter fine tuning
2022-05-07 Added some variables for hw revision. Added measurementdata for 2.1, yig filter at source side of mosfet
2022-05-10 Added initial arduino sketch
2022-05-19 Tested filter bank sweep
2022-06-09 Added some measurements for version 3 of the pcb
2022-12-11 Renamed arduino sketch and folder
2024-03-17 Updated to work with newer versions of arduino-mk and SerialCommands-library
2024-11-19 Added pcb
    [mux.sch, muxLevelShifter.sch, power.sch, relay_control.sch, yigBuffer.sch, yigController.kicad_pcb, yigController.sch, yigDrivers.sch]
2024-11-19 Added plot and updated to newer kicad version
    [mux.kicad_sch, muxLevelShifter.kicad_sch, power.kicad_sch, relay_control.kicad_sch, yigBuffer.kicad_sch, yigController.kicad_sch, yigDrivers.kicad_sch]
